raymirabel/ArduX1/doc/ArduX1_schematic.pdf

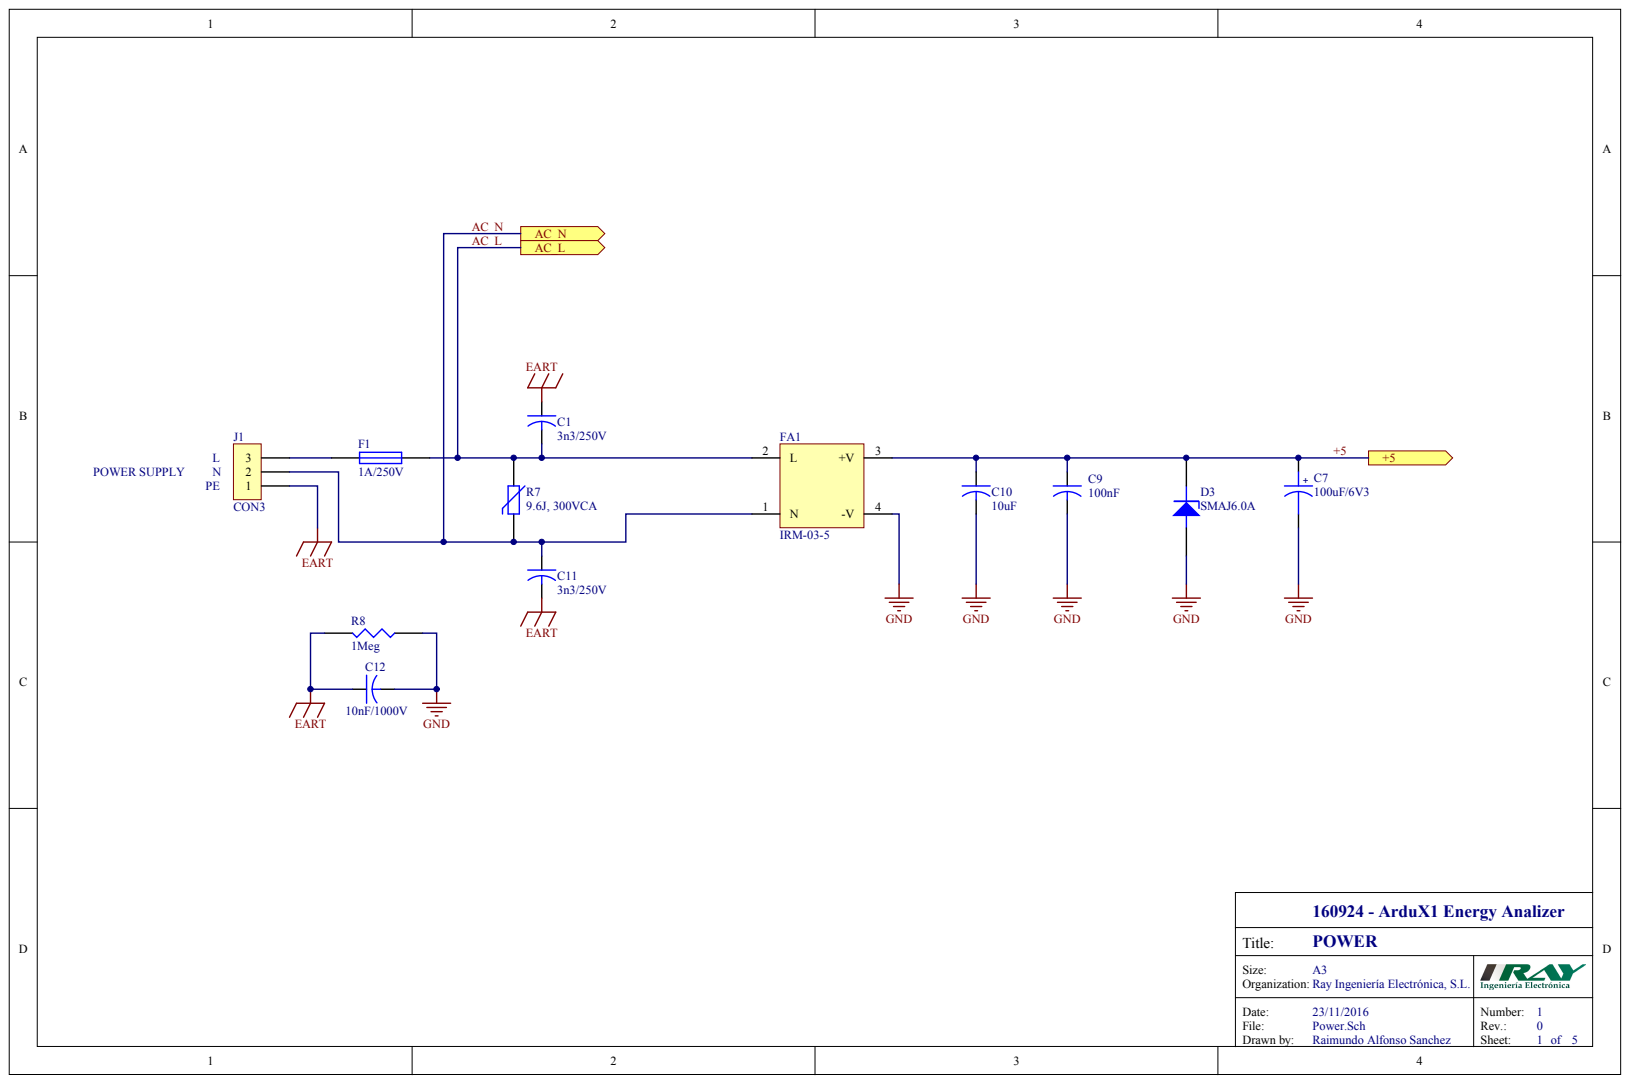
[picture p12: page 1]

Size : A 3 Organiza tion: Ray In g enierí a Electrónica, S.L.

Date: File: 23/11/2016 Power.Sch Drawn by : Raimundo A l fonso Sanche z | Number: 1 Rev.: Sheet: of

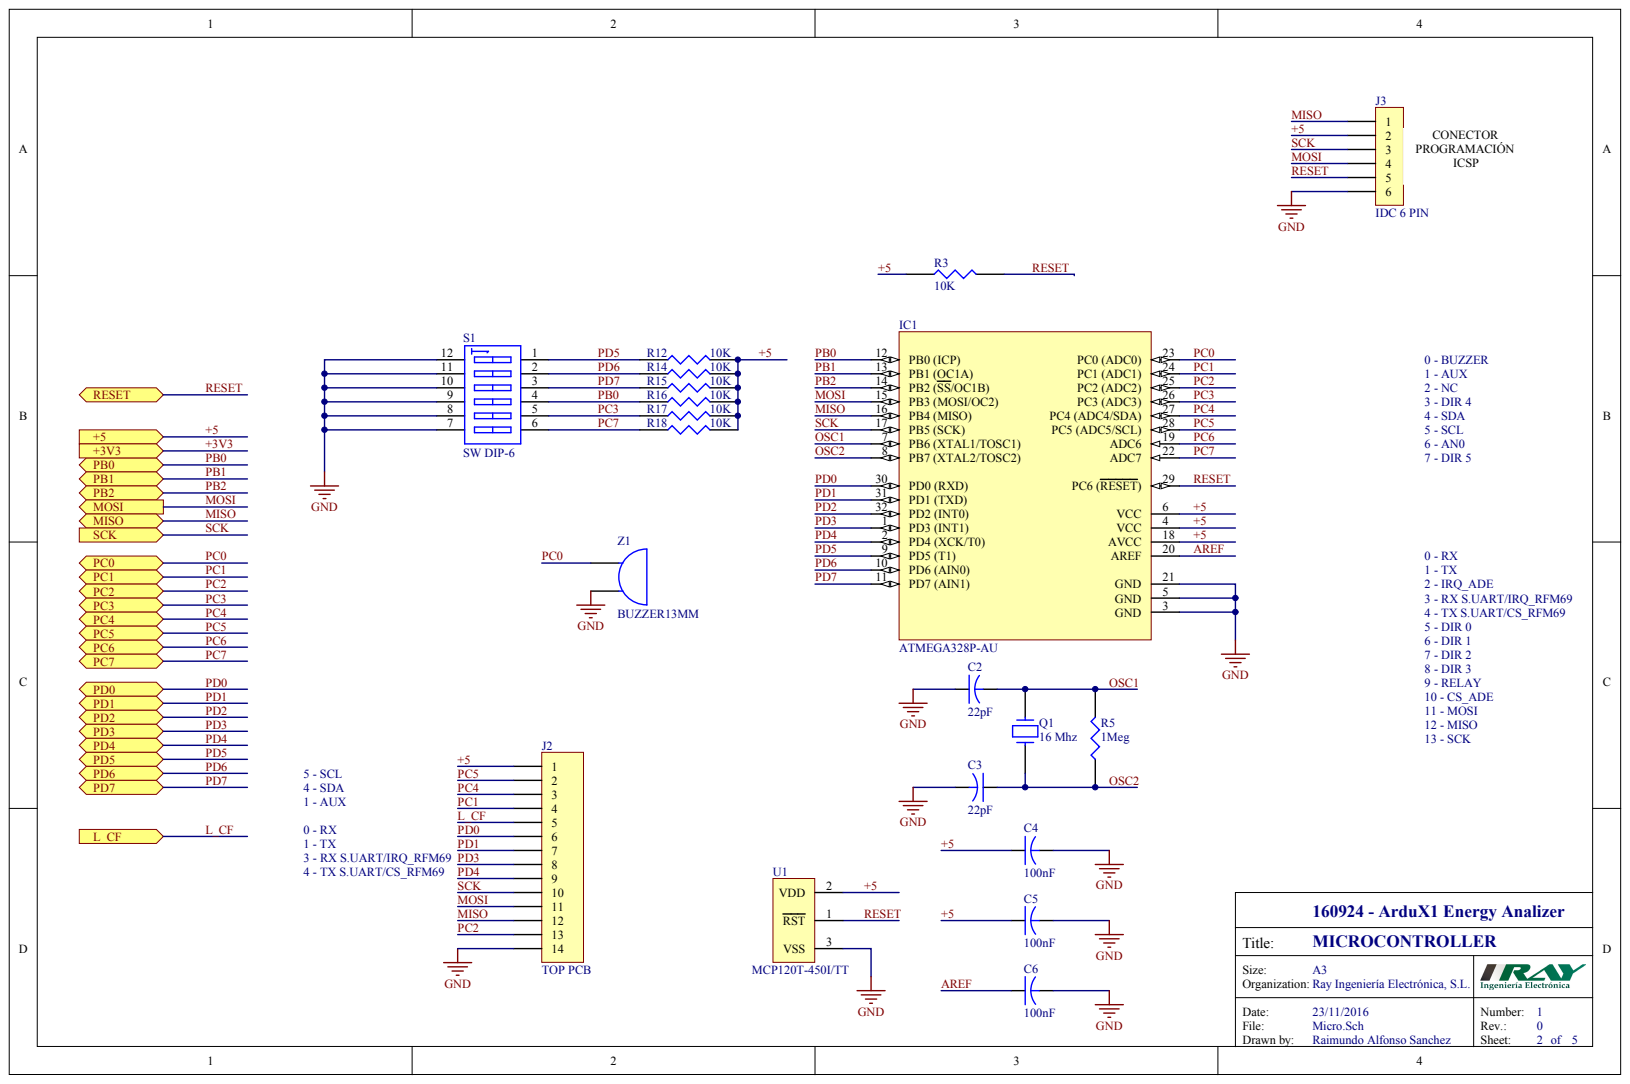
[picture p13: page 2]

Size : A 3 Organiza tion: Ray In g enierí a Electrónica, S.L.

Date: File: 23/11/2016 Micro.Sch | Number: 1

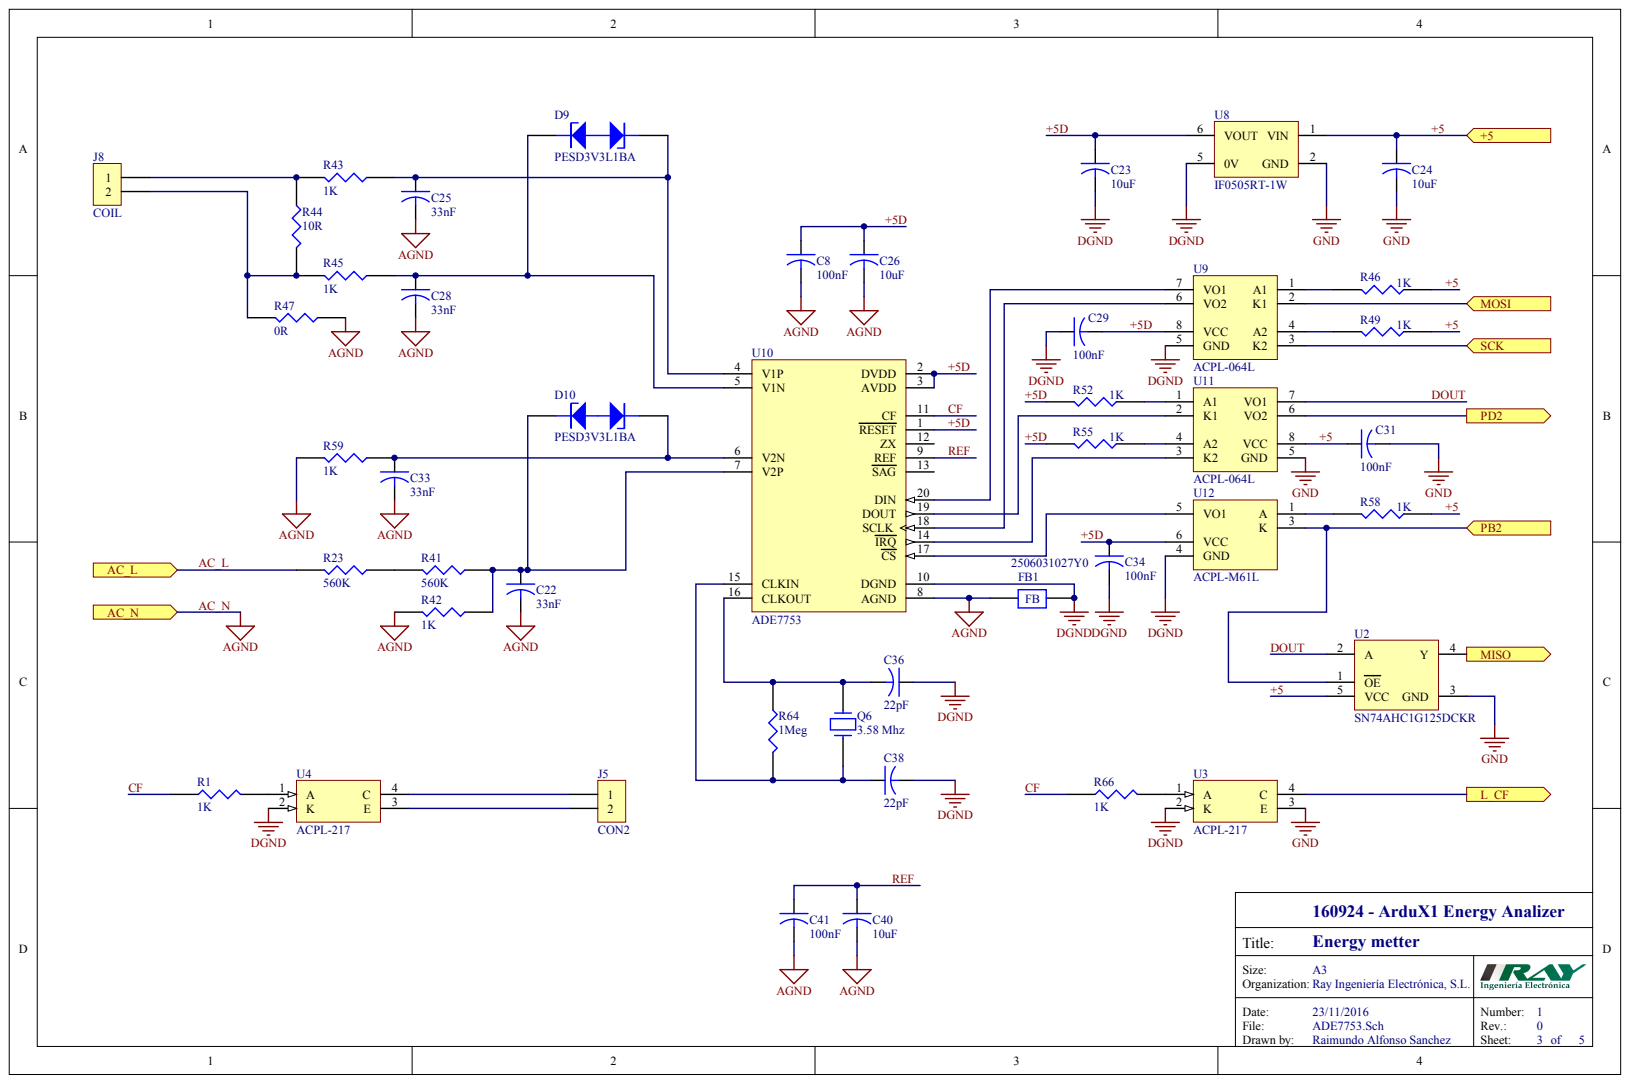
[picture p14: page 3]

Size: A3 Organization: Ray Ingeniería Electrónica, S.L.

Date: 23/11/2016 File: ADE7753.Sch Drawn by: Raimundo Alfonso Sanchez | Number: 1 0 Sheet: 3 5

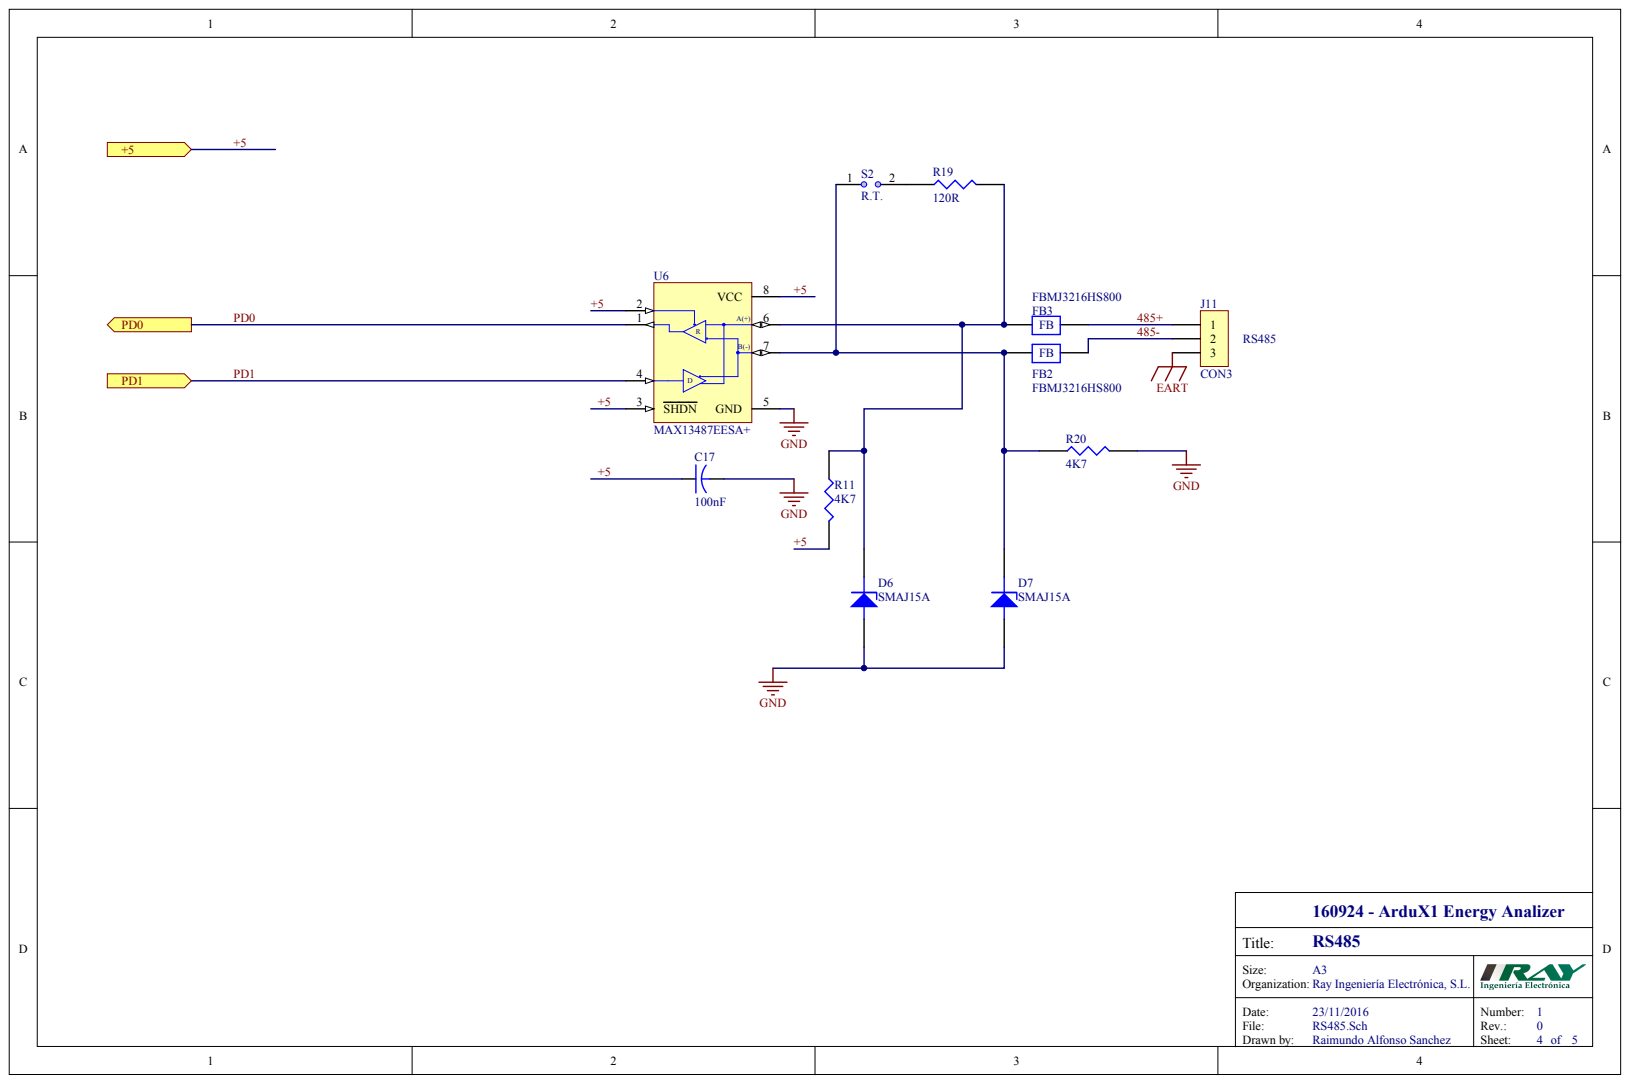
[picture p15: page 4]

Size: A3 Organization: Ray Ingeniería Electrónica, S.L.

Date: 23/11/2016 File: RS485.Sch Drawn by: Raimundo Alfonso Sanchez | Number: 1 Sheet: 4 5

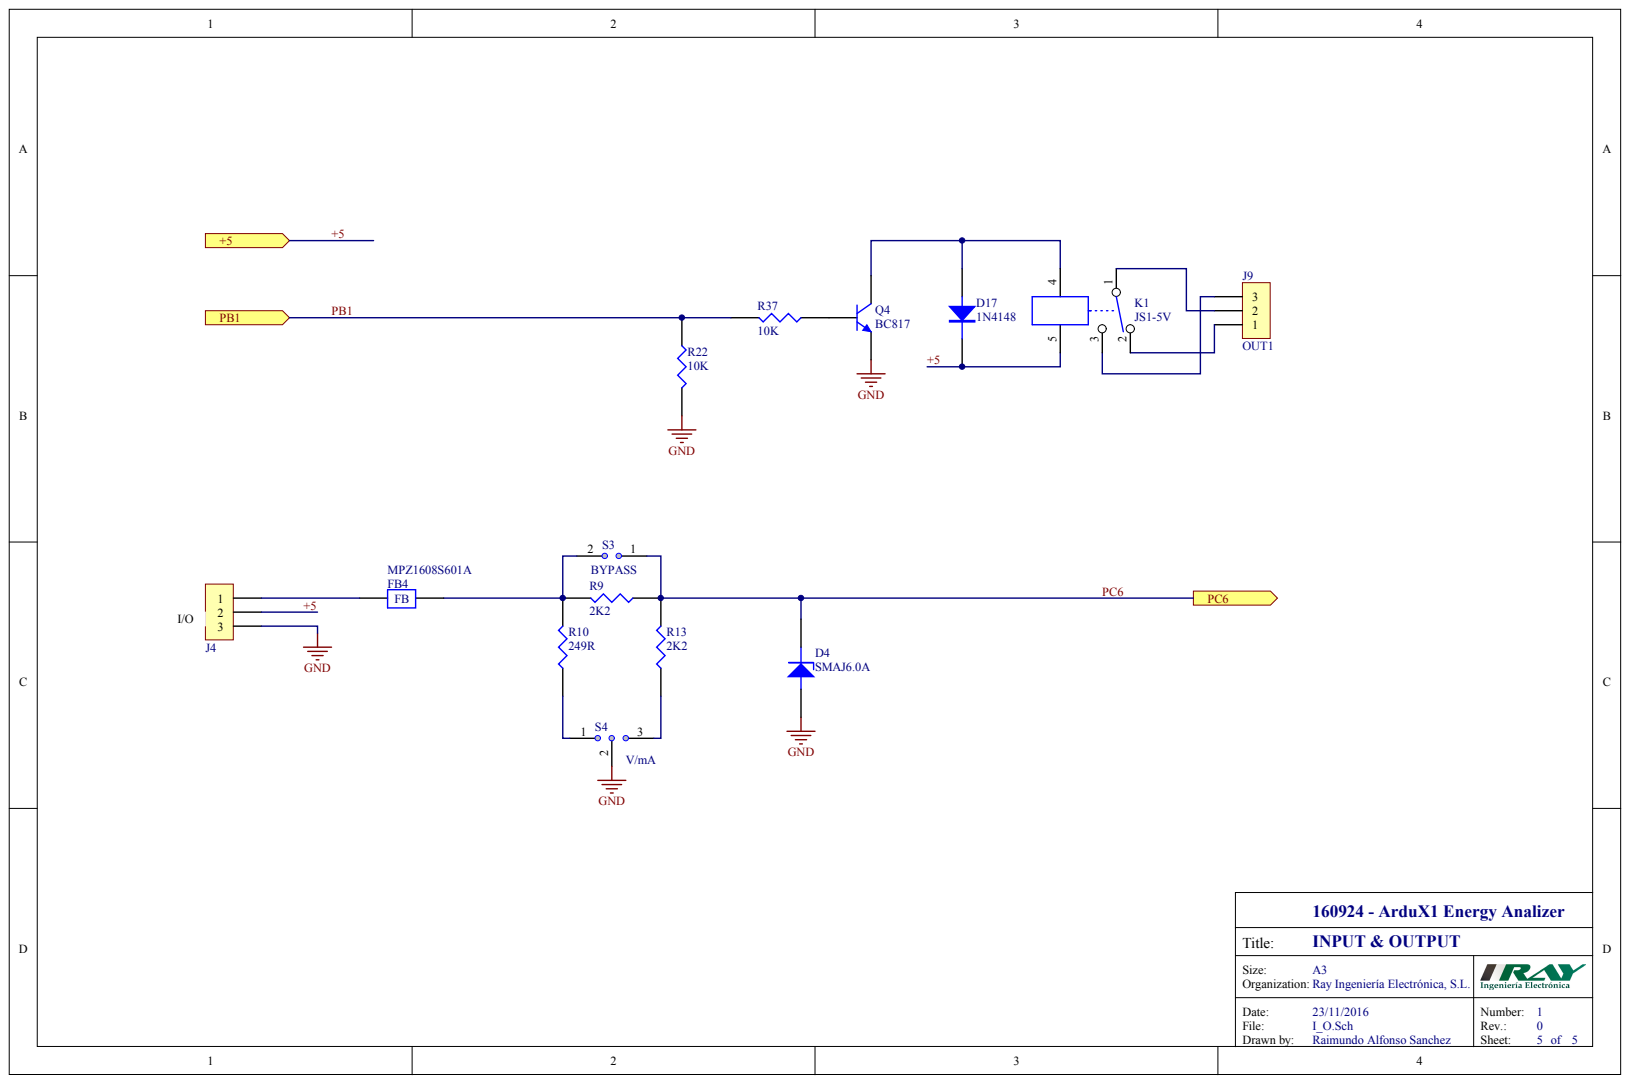
[picture p16: page 5]

Size : A 3 Organiza tion: Ray In g enierí a Electrónica, S.L.

Date: File: 23/11/2016 I_O.Sch | Number: 1
